edmugu/arduino_portable_adjustable_power_supply/Jekyll_page/original_demo_board.md

---
title: Original_demo_board
has_children: no
nav_order: 5
---

While doing tests on my board, I wanted to compare my design to the reference design shown in the article. So I decided to look for demo boards for the same components used in the article. AND I COULD NOT BELIEVE IT!!! I found the original board still being sold on mouser.com. So I bought one to be able to compare it to my board. Even after getting the board, I was still in denial, the article was written in the summer of 2014, and the demo boards were still being sold in 2021. 

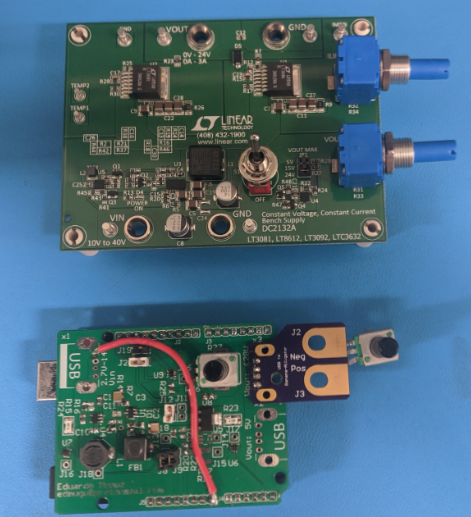
[picture p4: documentation/snippets/analog_ board_front_compared.PNG]
demo board front the front of the demo board


This made me feel great since I was able to tell that Analog Devices needed 3 revisions of this board to get this [simple design] right.

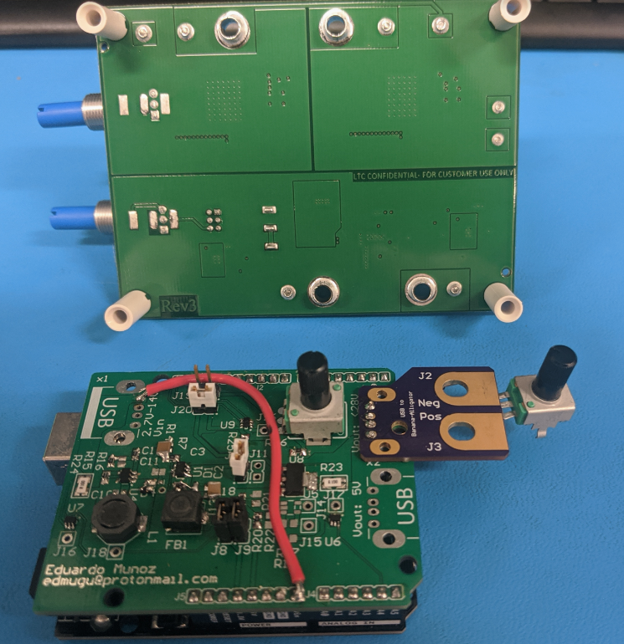
[picture p5: documentation/snippets/analog_board_back_compared.PNG]
demo board back the back of the demo board
