edmugu/arduino_portable_adjustable_power_supply/Rev. B/Jekyll_page/index.md

---
title: Rev. B
has_children: yes
nav_order: 4
has_toc: false
---

This is my second attempt at my power supply, and I corrected the issues described on "design flaws" and "debugging" pages of rev. A
