edmugu/arduino_portable_adjustable_power_supply/Rev. A/jekyll_page/CLI.md

---
title: CLI
has_children: no
parent: Rev. A
nav_order: 5
---

# Command Line Interface

The easiest way to monitor voltage is to use the Arduino Firmata library. This can easily be uploaded by the Arduino IDE by opening the firmata project and uploading it to the Arduino. Afterward, you can run the /python/read_voltage.py script provided in this report.

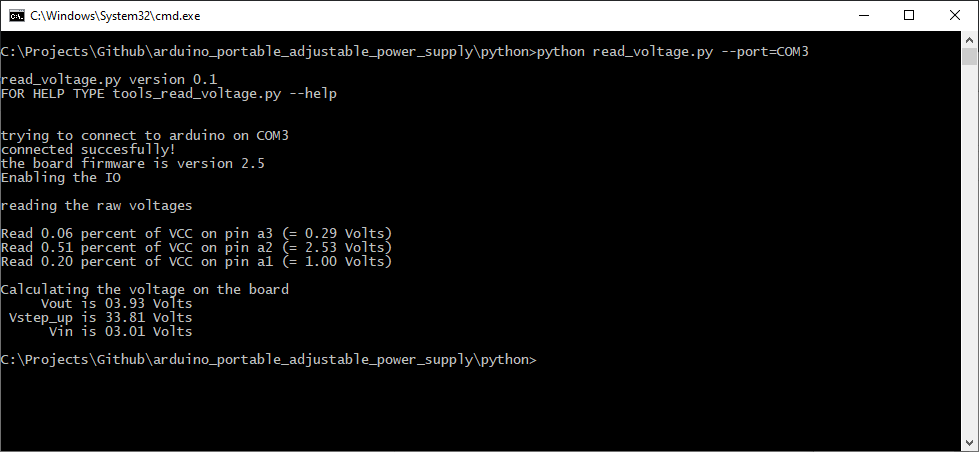
[picture p12: documentation/snippets/read_voltage.py.png]
