edmugu/arduino_portable_adjustable_power_supply/Rev. B/Jekyll_page/Updates.md

---
layout: default
title: Rev. B Updates
nav_order: 2
parent: Rev. B
---

## (1) Regulators vs. Controllers

After debugging Rev. A, I noted that at the moment, there was no IC sold in Digi key that could output over >13 amps **with the same package** [check page "Rev. A / Design Flaws" page for explanation ]. That is when I realized that voltage controllers are more upgradeable than voltage regulators. The reason is that a voltage regulator is a voltage controller WITH a power transistor and current sense mechanism. So if you want to upgrade your voltage controller power supply to handle more power, you have to update the power transistor and/or current sense mechanism. And if you want to upgrade a voltage regulator, you hope there is an IC with the same package that meets your requirements. 

Also, while designing Rev A , I did not realize that the final linear voltage regular used **LM317** is very inefficient since it requires at least a 3-volts difference between the input and the output. That is when I can with the **MIC5157** voltage controller. 

## (2) Reverse Voltage Protection

This is something that was not included on Rev. A at all, and it is important. 

## (3) Minimum voltage output

The minimum voltage output most voltage regulators can output is its internal reference voltage level. So most regulators can't go below 1.2 Volts by themselves. And this bothers me since the reference design from Linear Technologies can be to 0 volts. Then I found this article from Texas Instruments on how to tackle this issue which is [linked here](https://github.com/edmugu/arduino_adjustable_power_supply/blob/master/documentation/TI_Below_1V2.pdf)
