edmugu/arduino_portable_adjustable_power_supply/Rev. A/Schematics/Arduino Portable Power Supply Rev A0.pdf

# PAGE 0 -- Logical Schematics

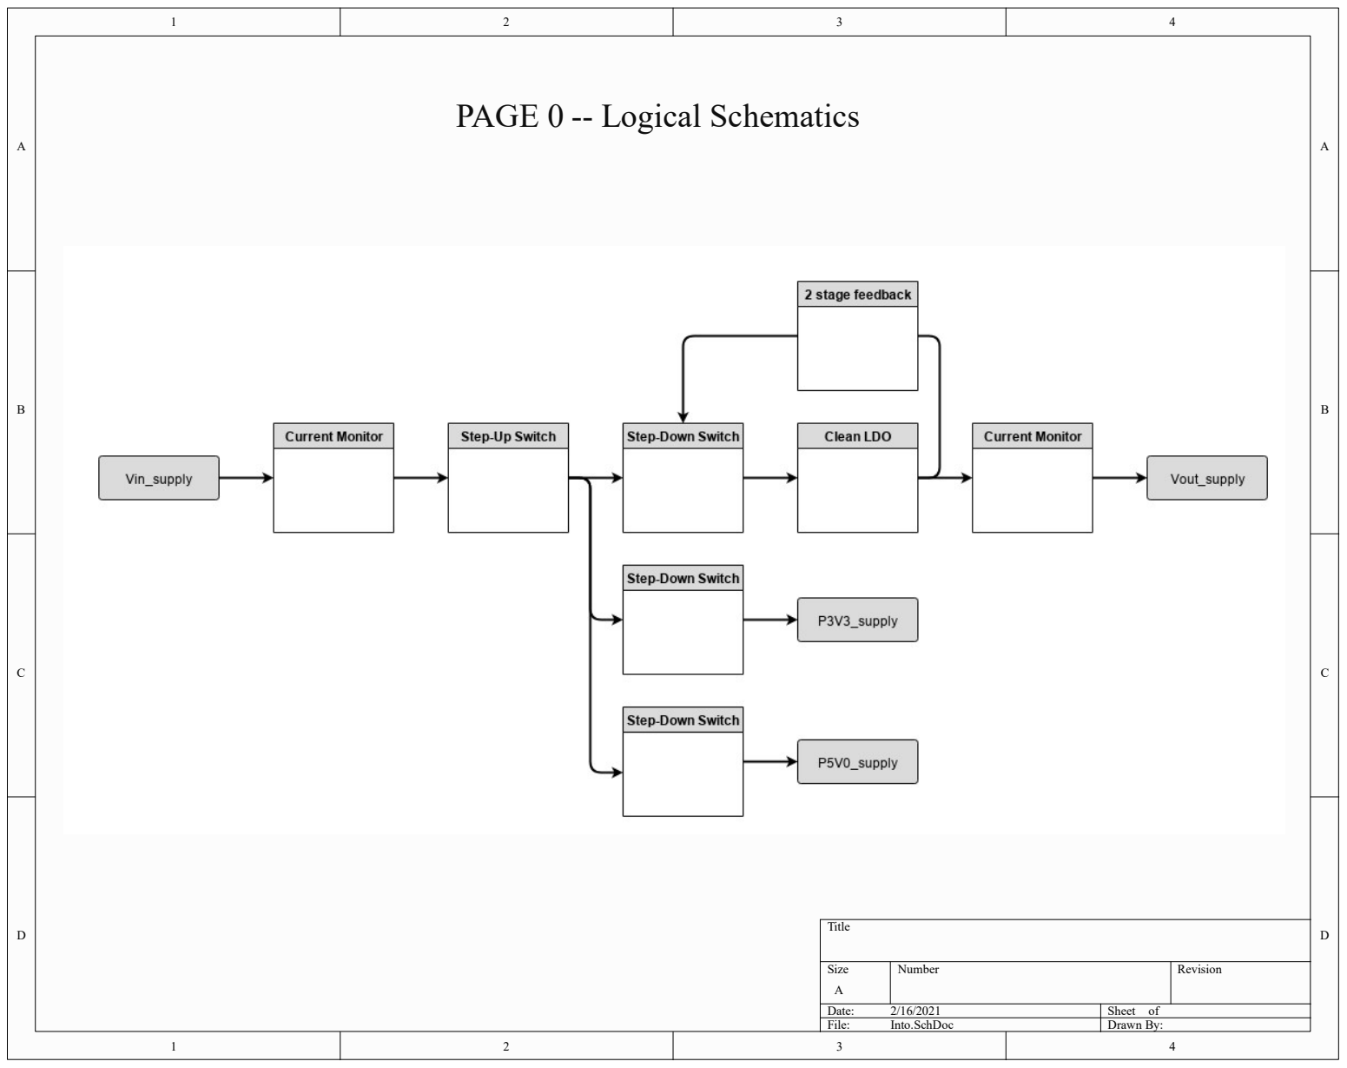
[picture p13: page 1]

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
Title

Size | Number | Revision
A
Date: | 2/16/2021 | Sheet of
File: | Into.SchDoc | Drawn By:

# PAGE 3 -- Step-Down Switch

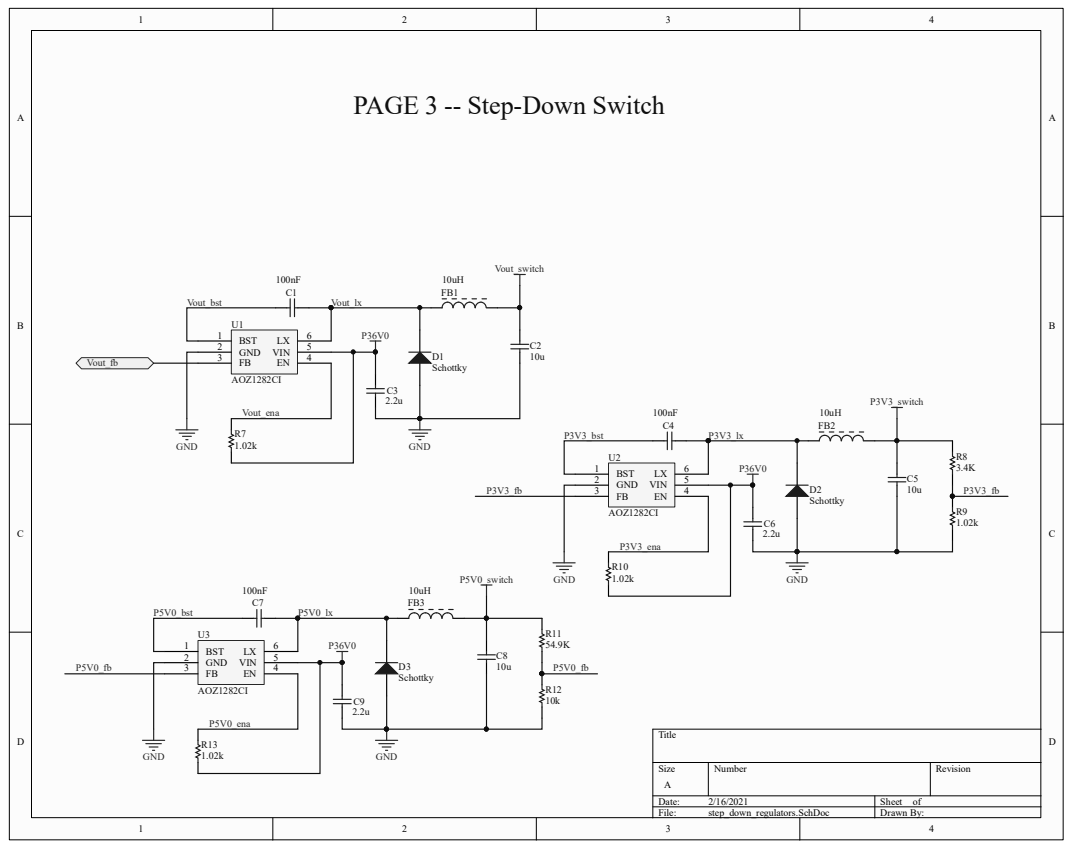
[picture p14: page 4]

# PAGE 6 -- Current Monitors

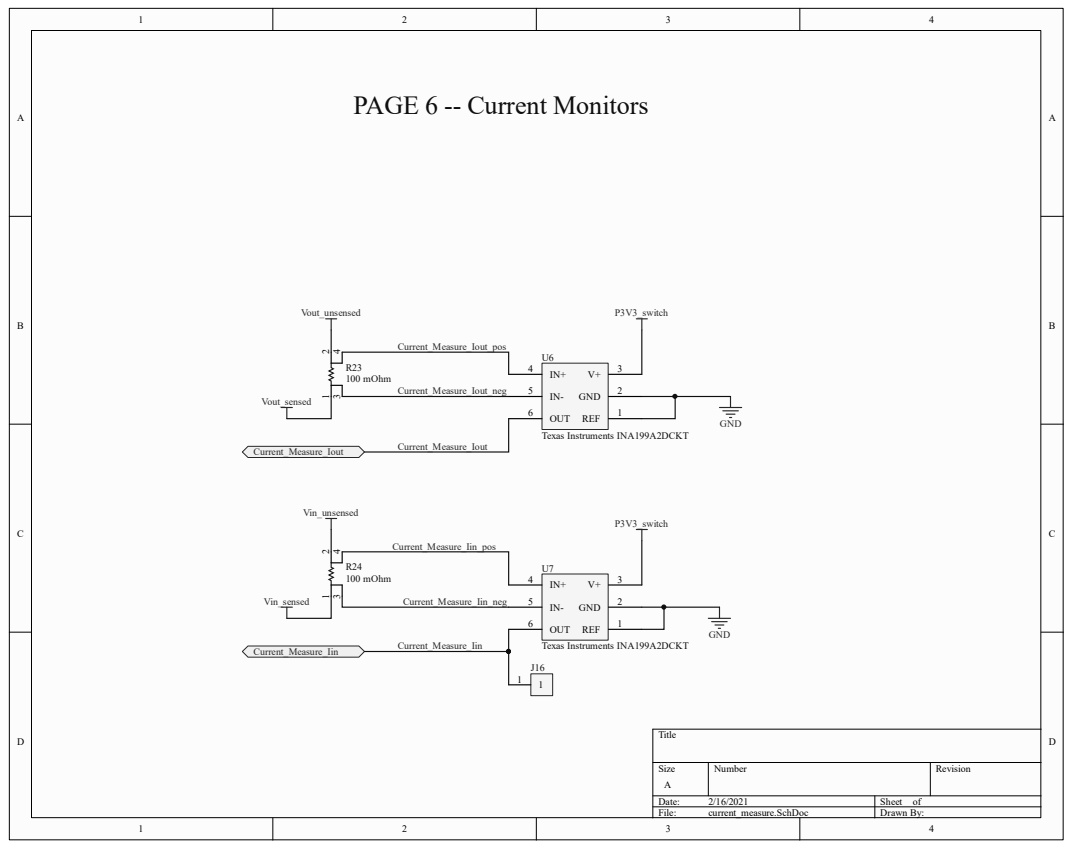
[picture p15: page 7]
Title; Size; Number; Revision; File:; current_measure.SchDoc; Drawn By:; REF; GND; OUT 6; Texas Instruments INA199A2DCKT; Vin_unsensed; Vout_unsensed; 100 mOhm; Vin_sensed; Vout_sensed; P3V3_switch; Current_Measure_Iin; Current_Measure_Iout; Current_Measure_Iout_pos; Current_Measure_Iout_neg; Current_Measure_Iin_pos; Current_Measure_Iin_neg

# PAGE 7 -- IO

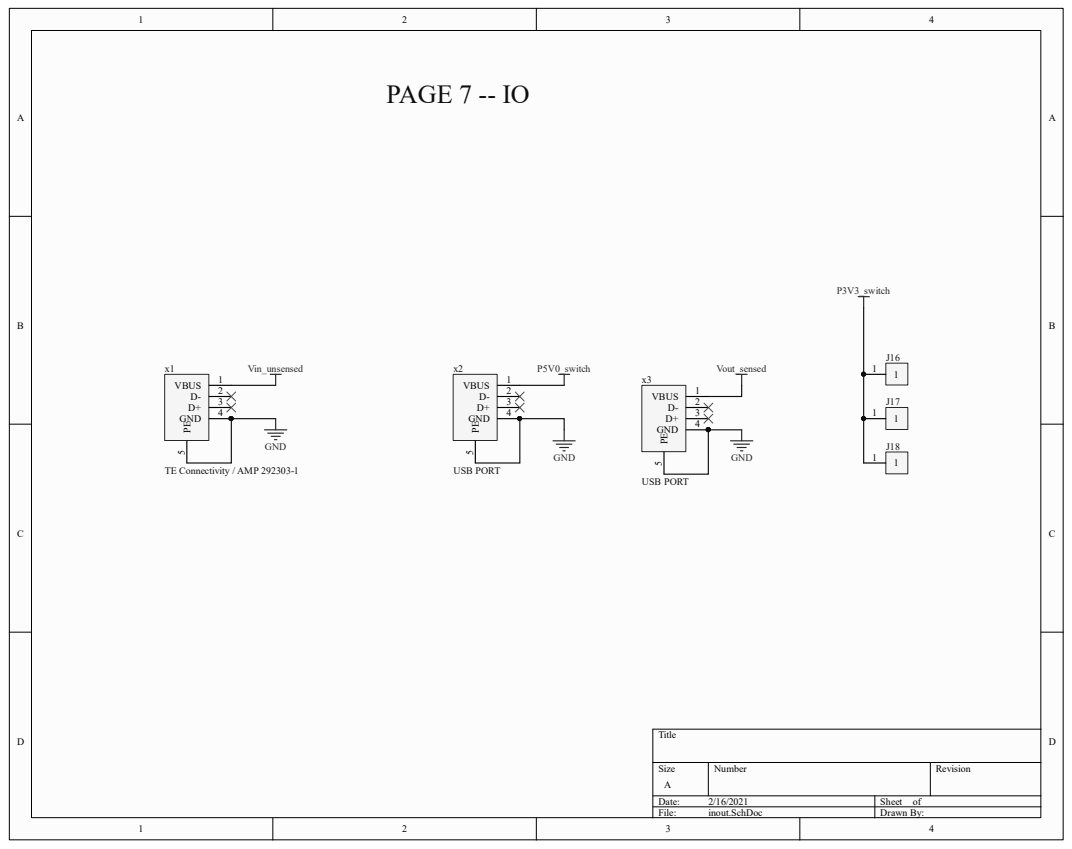
[picture p16: page 8]
Title; Size; Number; Revision; File:; inout.SchDoc; Drawn By:; P3V3_switch; GND; Vin_unsensed; P5V0_switch; Vout_sensed; VBUS; USB PORT

TE Connectivity / AMP 292303-1
