edmugu/arduino_portable_adjustable_power_supply/Rev. A/measurements/step_down.csv.png

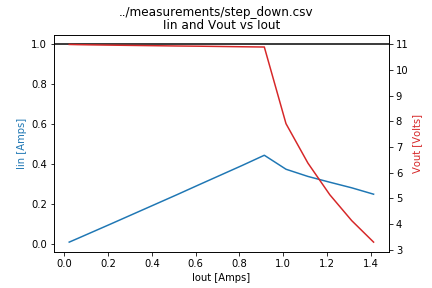
Rev. A/measurements/step_down.csv.png
