edmugu/arduino_portable_adjustable_power_supply/Rev. A/measurements/step_down_step_up_5V_in.csv.png

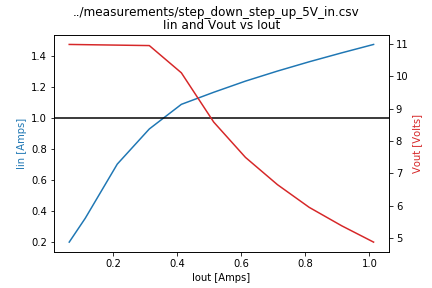
Rev. A/measurements/step_down_step_up_5V_in.csv.png
