edmugu/arduino_portable_adjustable_power_supply/Rev. A/measurements/step_up_12V_in.csv.png

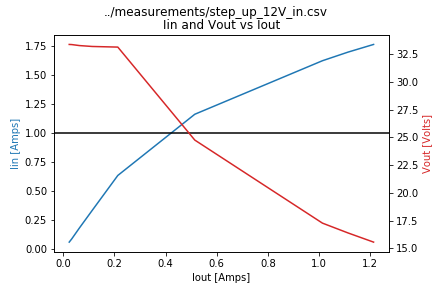
Rev. A/measurements/step_up_12V_in.csv.png
