edmugu/arduino_portable_adjustable_power_supply/Jekyll_page/Tester.md

---
title: Tester
has_children: no
nav_order: 2
---

# Tester
A tester capable of testing all the stages individually and together is descried here https://edmugu.github.io/power_supply_tester/
