edmugu/arduino_portable_adjustable_power_supply/Rev. A/jekyll_page/Thermal_test.md

---
title: Thermal_test
has_children: no
nav_order: 6
parent: Rev. A
---

## Thermal test
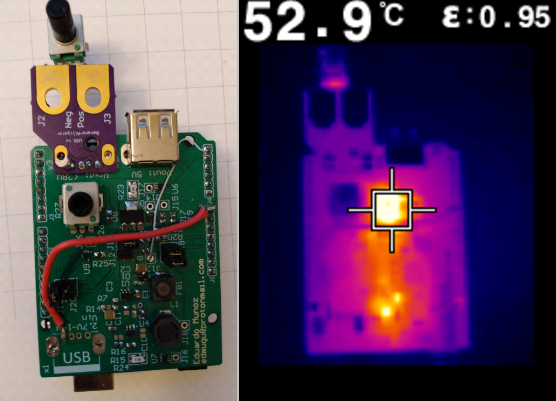
[picture p26: documentation/snippets/1_watt_thermal.PNG]
thermal picture Thermal picture
