edmugu/arduino_portable_adjustable_power_supply/tester/Tester.md

---
title: Tester
has_children: no
nav_order: 50
---

# Tester
