edmugu/arduino_portable_adjustable_power_supply/documentation/snippets/analog_board_temp_test_1.PNG

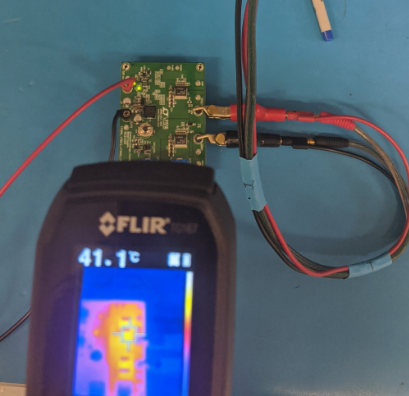
documentation/snippets/analog_board_temp_test_1.PNG
