edmugu/arduino_portable_adjustable_power_supply/Rev. A/simulations/complete_circuit_with_dynamic_feedback.asc

C1: polcap; 10µ; V=33 Irms=0 Rser=0.3 Lser=0 mfg="KEMET" pn="T495D106M035AS" type="Tantalum"
C2: cap; 33µ
C3: cap; 10µ
C4: cap; 100p
C5: cap; 10µ
C6: cap; .47µ
C7: cap; 4.7µ
C8: cap; 2.2µ
C9: cap; .47µ
C10: cap; 4.7µ
C11: cap; 2.2µ
D1: schottky; 1N5818
D2: diode; 1N914
L1: ind; 60µH
L2: ind; 6.8µ
L3: ind; 6.8µ
R1: res; 27k
R2: res; 120
R3: res; 2.4k
R4: res; 27k
R5: res; 1.2k
R6: res; 1.2k
R7: res; .01
R8: res; 3k
R9: res; 1k
R10: res; 3k
R11: res; 1k
Rload: res; 25
U1: LT1413
U2: LT1578
U3: LT3473
U4: LT3473
U5: LT317A
Vin: voltage; 14
Named nets: 0, step-down, step_up, vin, vout, vfeed
.tran 0 2m 0 1u
