edmugu/arduino_portable_adjustable_power_supply/Rev. A/simulations/final_output.asc

C1: polcap; 10µ; V=33 Irms=0 Rser=0.3 Lser=0 mfg="KEMET" pn="T495D106M035AS" type="Tantalum"
C2: cap; 33µ
C3: cap; 10µ
C4: cap; 100p
C5: cap; 10µ
C6: cap; .47µ
C7: cap; 4.7µ
C8: cap; 2.2µ
D1: schottky; 1N5818
D2: diode; 1N914
I1: current; 10
L1: ind; 15µH
L2: ind; 6.8µ
R1: res; 2000k
R2: res; 121
R3: res; 154
R4: res; 8.6K
R5: res; 5K
R6: res; 100k
U1: LT1117
U2: LT1578
U3: LT3473
V1: voltage; 4.25
Named nets: 0
.tran 300u
