edmugu/arduino_portable_adjustable_power_supply/(commit log)

2021-02-17 Create Arduino Portable Power Supply Rev A0.pdf
2021-02-17 Update Arduino Portable Power Supply Rev A0.pdf
2021-02-23 Adds board.py
    This is a class to keep all helper functions regarding the Arduino
2021-02-24 Update board.py
    Updates print method
2021-02-24 Update board.py
    Adds calculate_power
2021-02-24 Deleted the merged files from board.py
2021-02-25 Update board.py
    Added efficiency method
2021-02-25 Update board.py
    Adds a log to keep data
2021-03-08 Update board.py
    Removes the read_retries argument
2021-03-15 Adds java simulator
    [amp-diff.txt, diff.txt]
2021-03-27 Adds PCB_files.md
2021-05-05 Adds Analog board pictures
2021-05-19 Adds measurements with E-Load
    [step_down.csv, step_down_step_up_12V_in.csv, step_down_step_up_5V_in.csv, step_up_12V_in.csv, step_up_5V_in.csv]
2021-05-20 Adds diagrams
    [step_down.csv]
2021-05-21 moves files to Rev A folder
    [amp-diff.txt, diff.txt, rev_B_tester_access.csv, step_down.csv, step_down_step_up_12V_in.csv, step_down_step_up_5V_in.csv, step_up_12V_in.csv, step_up_5V_in.csv]
2021-05-21 moves documentation folder to main folder
    [rev_B_tester_access.csv]
